tungstenexe/tungsten-V6/TungstenV6_Circuit/TV6circuit_01_overall.jpg

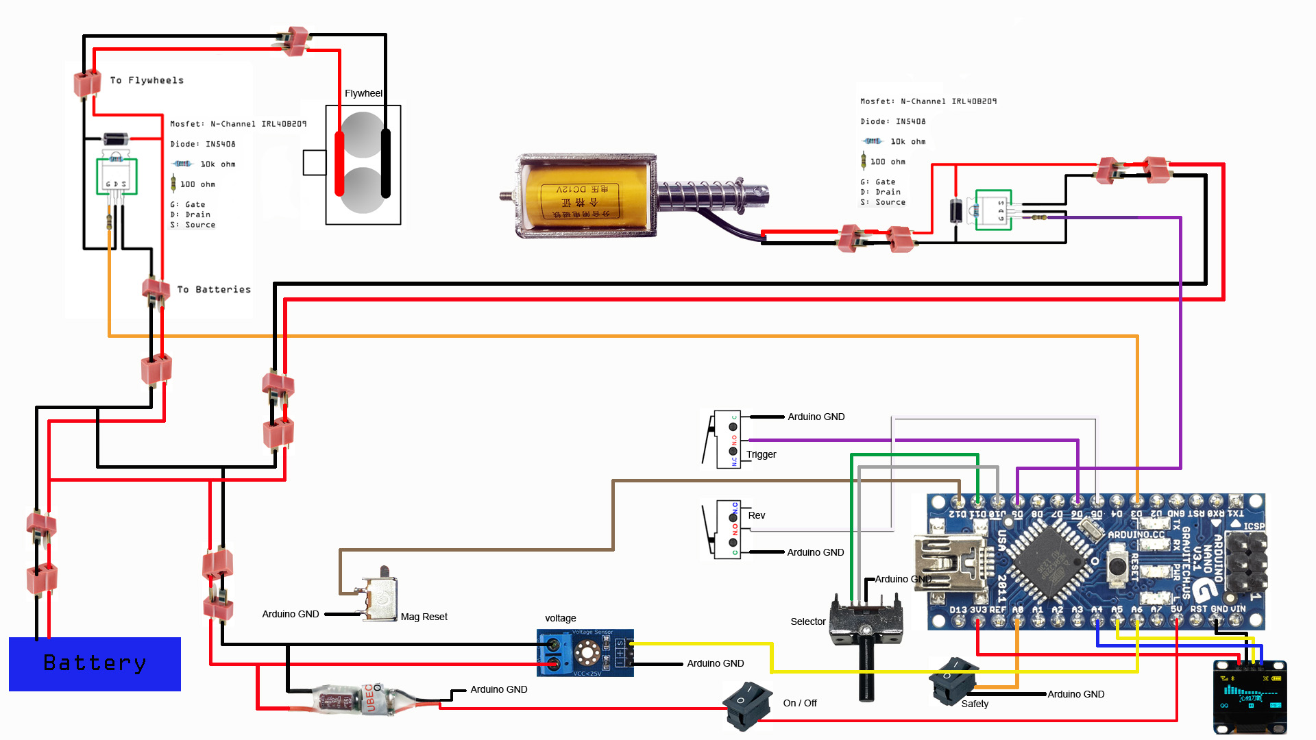
TungstenV6_Circuit/TV6circuit_01_overall.jpg
