tungstenexe/tungsten-V6/TungstenV6_Circuit/TV6circuit_02_FlyWheel.jpg

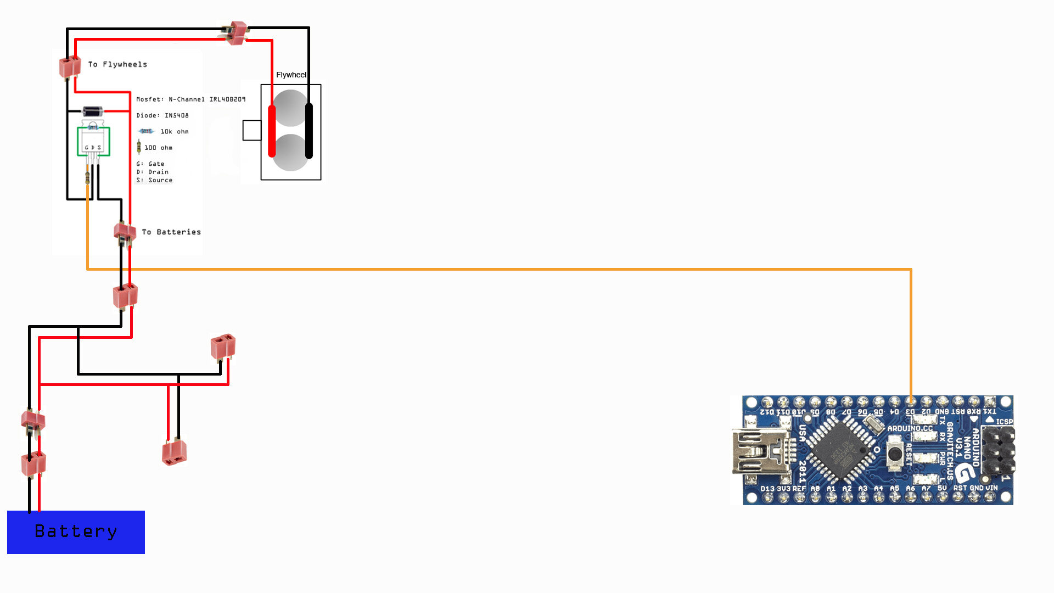
TungstenV6_Circuit/TV6circuit_02_FlyWheel.jpg
