tungstenexe/tungsten-V6/TungstenV6_Circuit/TV6circuit_03_MagReset.jpg

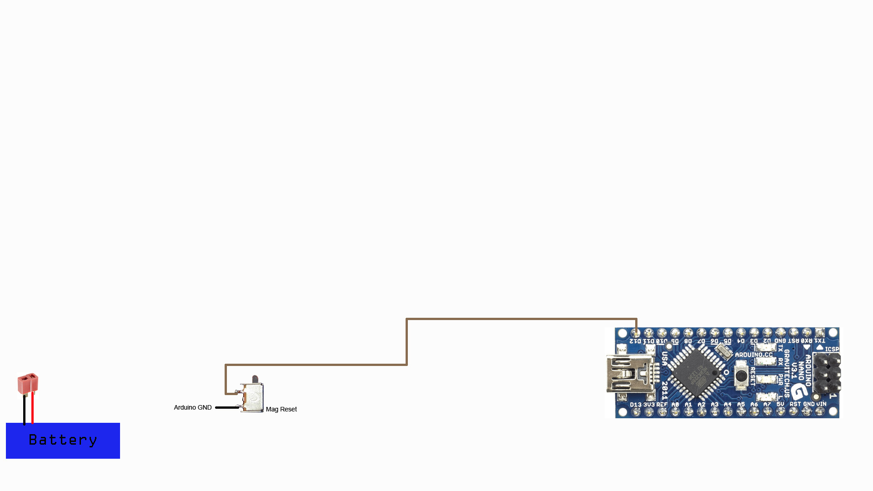
TungstenV6_Circuit/TV6circuit_03_MagReset.jpg
