tungstenexe/tungsten-V6/TungstenV6_Circuit/TV6circuit_05_OnOffSafety.jpg

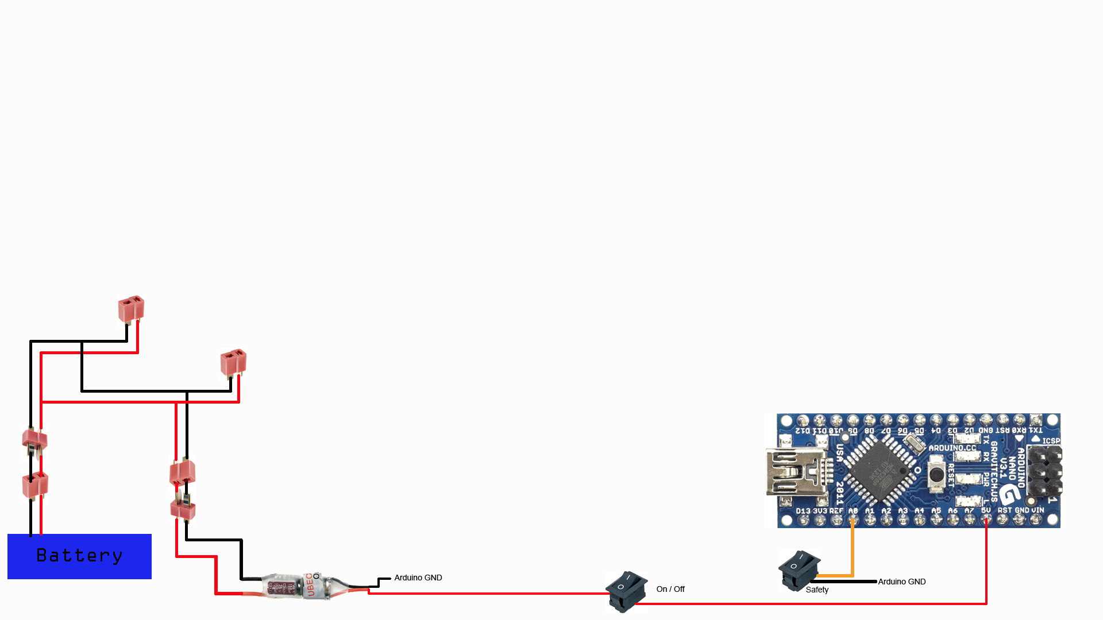
TungstenV6_Circuit/TV6circuit_05_OnOffSafety.jpg
