tungstenexe/tungsten-V6/TungstenV6_Circuit/TV6circuit_06_Selector.jpg

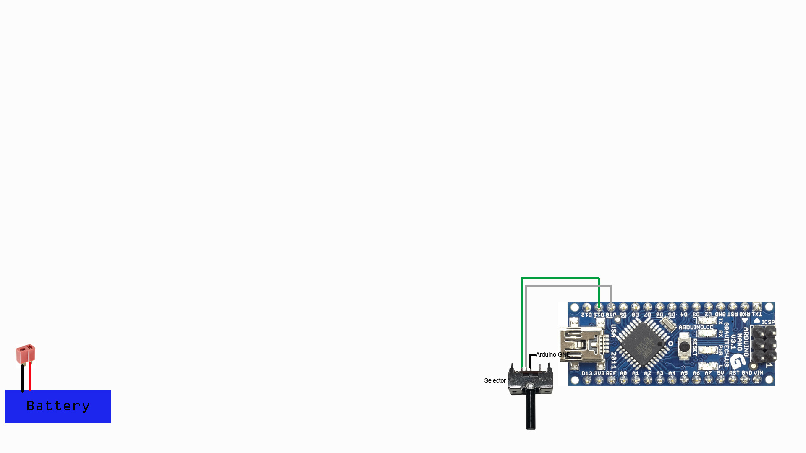
TungstenV6_Circuit/TV6circuit_06_Selector.jpg
