tungstenexe/tungsten-V6/TungstenV6_Circuit/TV6circuit_08_Voltage.jpg

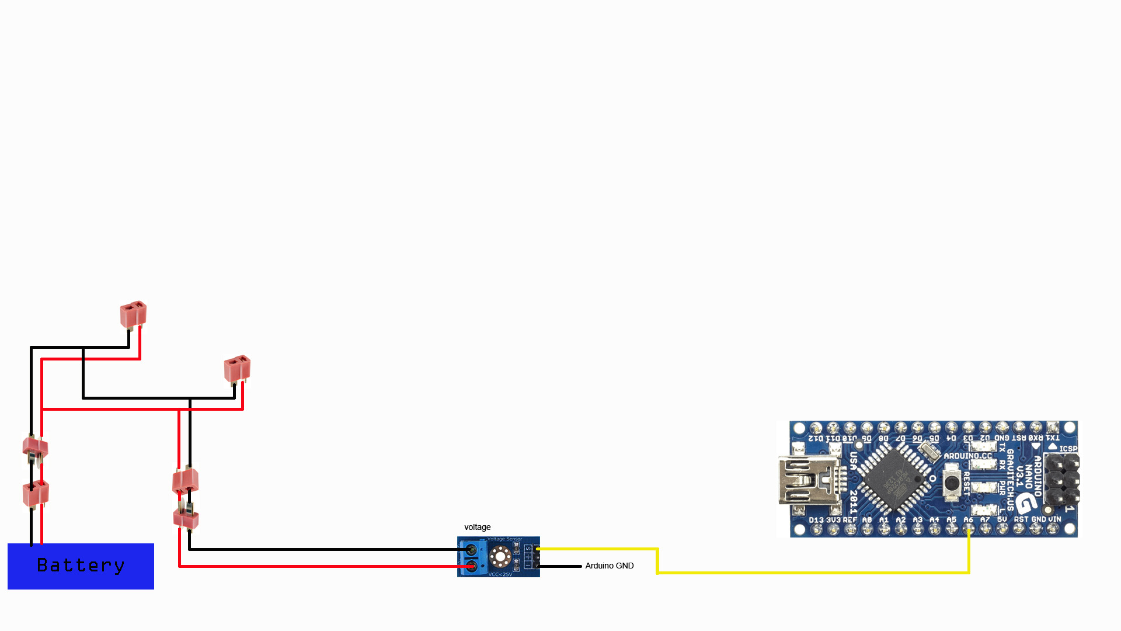
TungstenV6_Circuit/TV6circuit_08_Voltage.jpg
