tungstenexe/tungsten-V6/TungstenV6_Circuit/TV6circuit_09_Solenoid.jpg

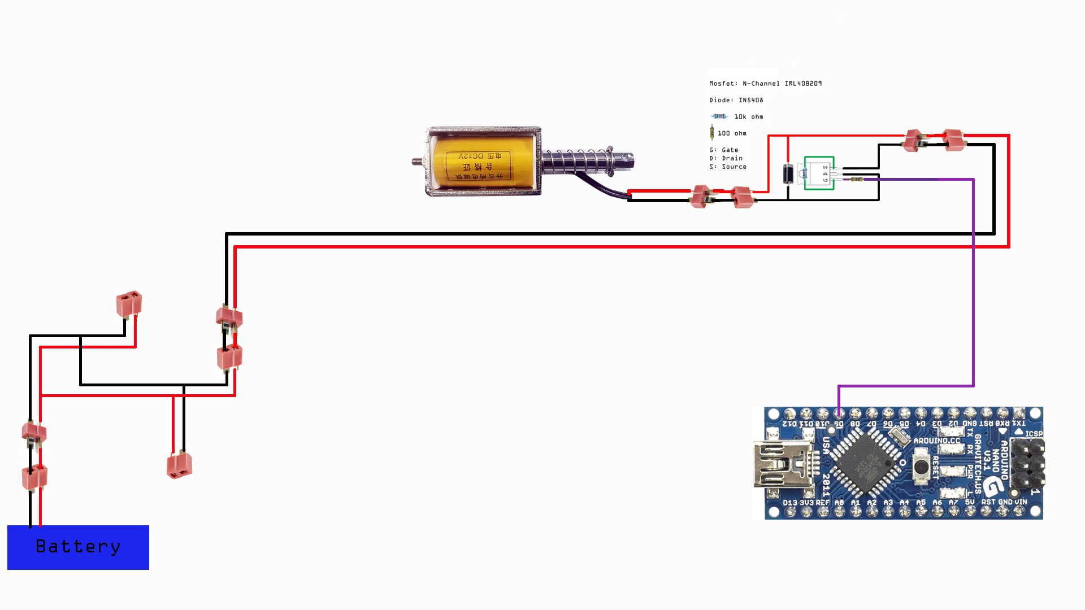
TungstenV6_Circuit/TV6circuit_09_Solenoid.jpg
